mindcont/open-source/README.md

#  开源 OpenSource
本项目用来分享我所收集的优秀的开源代码。<br>
This folder will be used to share my collection of open source projects

## 开源代码目录
文件夹 | 说明 |
-----|--------|
Linux | Linus Torvalds 先生开源的早期 Linux 系统源码（含赵炯先生源码注释）
Apple II DOS | 苹果公司开源的早期 Apple II DOS系统源码
Microsoft DOS | 微软公司开源的早期 DOS 系统源码
Facebook | Facebook 开源硬件Surround360
Kinect | 适用于微软公司Kinect 硬件的开源驱动和工具
RaspberryPi | 整理的一些有趣树莓派开源项目

## 开源代码说明
用来整理收集开源项目，旨在帮助像我一样希望学习计算机精华与灵魂的东西，阅读这些伟大作品的早期源码
无疑是一份极好的材料，仅希望对那些苦苦搜索早期资料的朋友有一点帮助。
遵循署名-相同方式共享 3.0 协议，版权归原作者和出版公司所有.

* ### Linux
  ```
  目录下包括：linux-0.11中文注释(赵炯) | OldLinux | 书籍
  其中
  linux-0.11中文注释(赵炯) 由赵炯先生注释
  OldLinux 同样来自赵炯先生著作《Linux 内核完全注释》所提供的学习网站中的内容

  你可以访问下面的链接，了解更多。
      http://www.oldlinux.org/index_cn.html
      ftp:http://www.oldlinux.org/Linux.old/

  书籍 目录下分享我收集到的基本比较好的Linux 系统学习资料
  ```

* ### Apple II DOS
  ```
  目录下包括：Apple II DOS | Books |Pictures
  其中 Apple II DOS 下 斯科特LaBombard 重建

  斯科特LaBombard，专用的老式电脑收藏家/恢复在纽约，已经做了了不起的工作，研究和重建的Apple II DOS源代码。
  在归档中的“shepdos”目录代表了我们从保罗·劳顿得到了扫描的上市工作，
  以及“appledos31”目录包 含重建的源代码相匹配的生产由苹果公司发布了DOS 3.1二进制文件。谢谢，斯科特！

  More information,you can view http://www.computerhistory.org/atchm/apple-ii-dos-source-code/
  ```

* ### Microsoft DOS
  ```
  目录下包括：Projects| Word 1.1a CHM Distribution | Pictures
  其中 Microsoft DOS 下包括早期 DOS 源码和编译好的文件
  
  Word 1.1a CHM Distribution 下这包含源代码，因为它存在于1991年1月10日。
  这是源代码用于构建Windows 1.1a字，代号为“作品”。
  图片下 包含早期的 DOS 图片。
  ```

* ### Facebook
  ```java
  Surround360 is Facebook's open source hardware and software for capturing stereoscopic 3D 360 video for VR.
  The repo contains hardware designs, as well as software for camera control and rendering.
  ```

* ### RaspberryPi
分享我所收集的有趣树莓派项目，欢迎大家fork和push ( /) V (\ ) 嘻嘻~

文件夹 | 说明 | 作者 | 开源地址 |
----|----|----|-----|
Big Dog | 基于3D打印的开源大狗 | HuskyRobo| http://www.instructables.com/id/Fenrir-an-Open-Source-Dog-Robot/
ngrok | 穿透内网 | inconshreveable | https://github.com/inconshreveable/ngrok

## 致谢
在此，感谢所有致力于开放源代码并为之努力的朋友们！
