mindcont/open-source/Kinect/Kinect_v2/README.md

## Kinect v2
适用于微软公司Kinect v2硬件的开源驱动和工具  


文件 | 说明 |作者 | 开源地址 |
----|----|----|----|
libfreenect2 |Open source drivers for the Kinect v2| OpenKinect | https://github.com/OpenKinect/libfreenect2 |  
Skeltrack | A Free Software skeleton tracking library | joaquimrocha | https://github.com/avin2/SensorKinect |
