mindcont/open-source/Facebook/Surround360/surround360_camera_ctl/source/www/camera_capture/README.txt

== Things to modify/consider when putting this code on a new computer/camera rig ==
- capture_image.php: $num_cameras, $fps, master camera serial number
