mindcont/open-source/RaspberryPI/README.md

分享我所收集的有趣树莓派项目，相关项目的开源文件也可以在此路径相应文件夹下进行下载。欢迎大家fork和push ( /) V (\ ) 嘻嘻~

flying_pi

## 目录
文件夹 | 说明 | 作者 | 开源地址 |
----|----|----|-----|
Big Dog | 基于3D打印的开源大狗 | HuskyRobo| http://www.instructables.com/id/Fenrir-an-Open-Source-Dog-Robot/
ngrok | 穿透内网 | inconshreveable | https://github.com/inconshreveable/ngrok

## 致谢
在此，感谢所有致力于开放源代码并为之努力的朋友们！

#### 1、Big Dog  
一个利用3D打印机和树莓派制作的开源大狗机器人  
博客地址：http://www.instructables.com/id/Fenrir-an-Open-Source-Dog-Robot/  
源码地址：https://github.com/HackHusky/Fenrir  
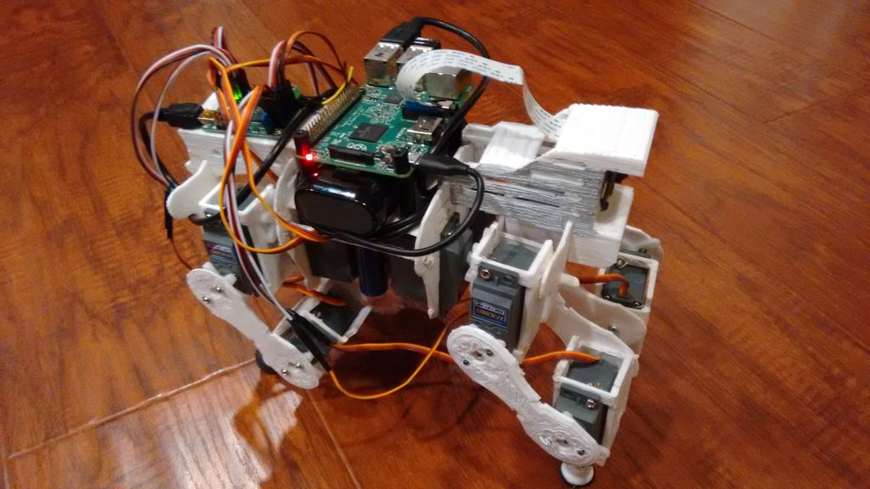
[picture p1: RaspberryPI/dog robot/dog robot.jpg]
dog robot
效果图： 

#### 2、ngrok  
穿透内网，可以远程控制家中路由下的树莓派喔～  
官网：https://ngrok.com/  
源码地址：https://github.com/inconshreveable/ngrok  
ngrok
