mindcont/open-source/Apple II DOS/Readme.txt

/************************************************
*
*	斯科特LaBombard，
*
*专用的老式电脑收藏家/恢复在纽约，已经做了了不起的工作，
*
*研究和重建的Apple II DOS源代码。他给了我们允许发布在这里他的工作结果：LaBombard_8Dec13.zip。（即本文件夹中的内容）
*
*在归档中的“shepdos”目录代表了我们从保罗·劳顿得到了扫描的上市工作，
*
*以及“appledos31”目录包 含重建的源代码相匹配的生产由苹果公司发布了DOS 3.1二进制文件。谢谢，斯科特！
*
*
*More information,you can view http://www.computerhistory.org/atchm/apple-ii-dos-source-code/
*
************************************************/
