mindcont/open-source/Kinect/Kinect_v1/README.md

## Kinect v1
适用于微软公司Kinect v1硬件的开源驱动和工具  


文件 | 说明 |作者 | 开源地址 |
----|----|----|----|
KinectCommonBridge-1.0.zip | Kinect Common Bridge | Microsoft Open Technologies, Inc | https://github.com/MSOpenTech/KinectCommonBridge |  
libfreenect-0.5.3.zip | Drivers and libraries | OpenKinect | https://github.com/OpenKinect/libfreenect |  
SensorKinect-0.93-5.1.2.1.zip | PrimeSensor Modules for OpenNI | avin2 | https://github.com/avin2/SensorKinect |  
OpenNI-Stable-1.5.7.10.zip | Open Natural Interaction | OpenNI | https://github.com/OpenNI/OpenNI |
