mindcont/open-source/Apple II DOS/pictures/01384303545.jpg_w600.jpg

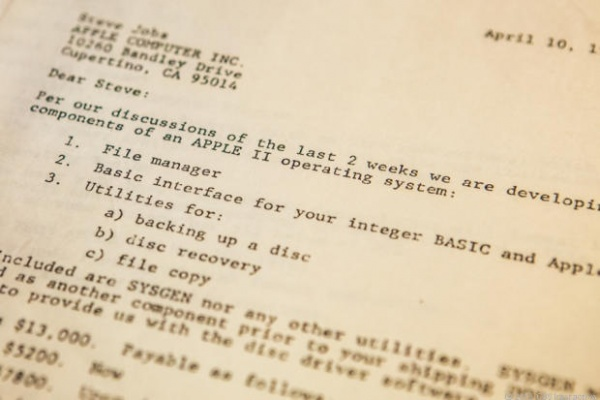
Apple II DOS/pictures/01384303545.jpg_w600.jpg
