mindcont/open-source/Apple II DOS/pictures/81384303567.jpg_w600.jpg

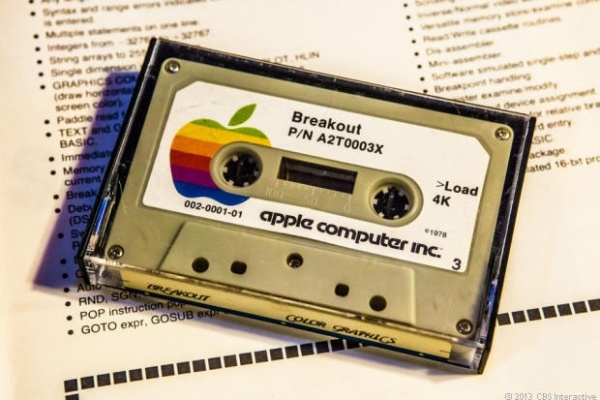
Apple II DOS/pictures/81384303567.jpg_w600.jpg
