mindcont/open-source/Apple II DOS/pictures/101384303572.jpg_w600.jpg

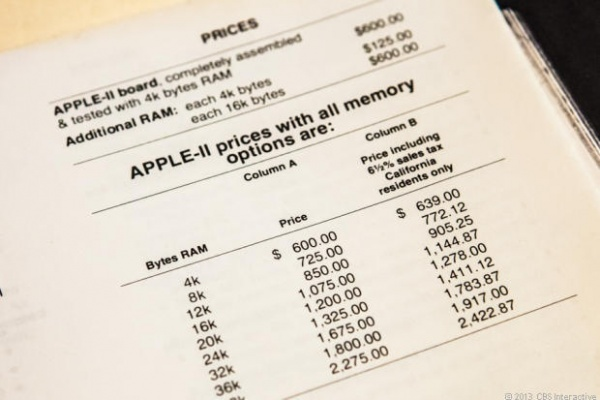
Apple II DOS/pictures/101384303572.jpg_w600.jpg
