mindcont/open-source/Apple II DOS/pictures/apple-II-02-542x347.jpg

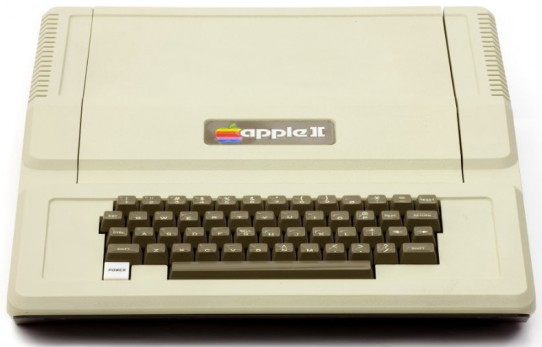
Apple II DOS/pictures/apple-II-02-542x347.jpg
