mindcont/open-source/Apple II DOS/pictures/apple-original-os-docs-2074_620x413.jpg

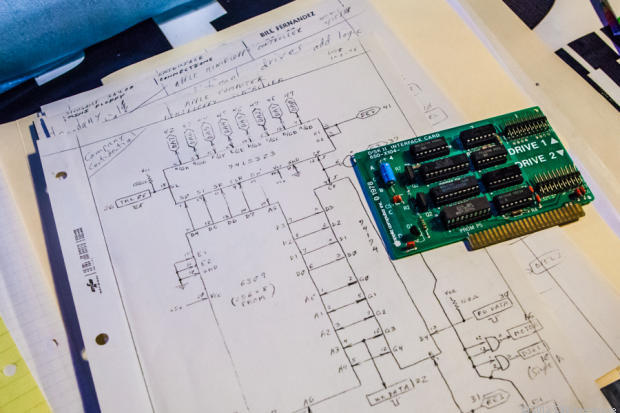
Apple II DOS/pictures/apple-original-os-docs-2074_620x413.jpg
