mindcont/open-source/Apple II DOS/pictures/pricelist_Oct1977.jpg

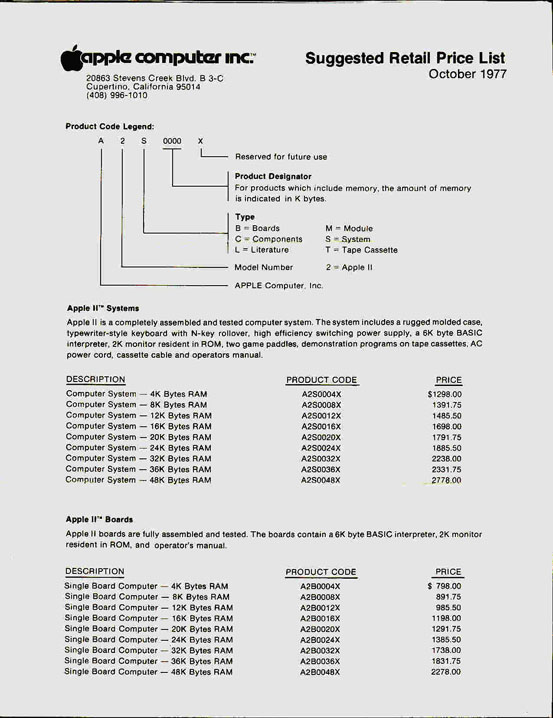
Apple II DOS/pictures/pricelist_Oct1977.jpg
