mindcont/open-source/Facebook/Surround360/surround360_design/3d_models/STEP_files/FB360_V1_33.STEP

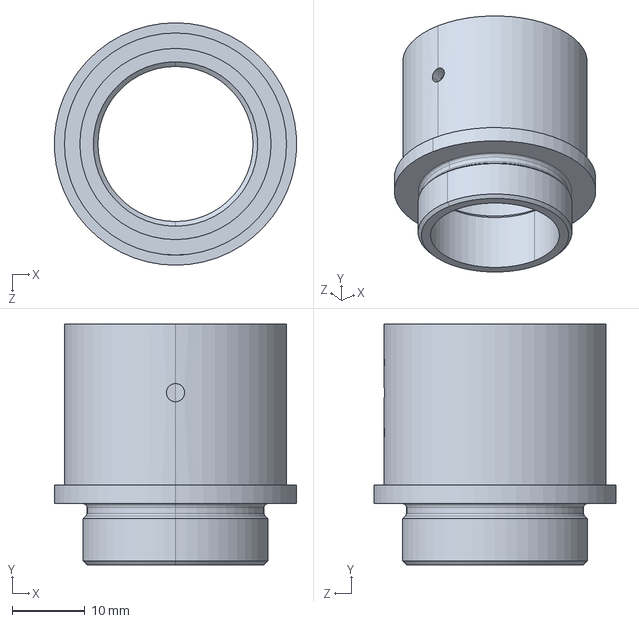
[picture p79: CAD file, 2016-07-31]
Facebook/Surround360/surround360_design/3d_models/STEP_files/FB360_V1_33.STEP
33.2 x 33.0 x 33.3 mm
