mindcont/open-source/(list of files, cad)

Other CAD files:
Microsoft DOS/Projects/v20object/SYSINIT.OBJ
Microsoft DOS/Word 1.1a CHM Distribution/Opus/sdm/dbg/sdmcomp.obj
Microsoft DOS/Word 1.1a CHM Distribution/Opus/sdm/hybrid/sdmnat2.obj
Microsoft DOS/Word 1.1a CHM Distribution/Opus/sdm/nondbg/sdmnat.obj
Microsoft DOS/Projects/v20object/FORMAT.OBJ
Microsoft DOS/Word 1.1a CHM Distribution/Opus/sdm/dbg/sdmnat2.obj
Microsoft DOS/Word 1.1a CHM Distribution/Opus/sdm/hybrid/sdmcomp.obj
Microsoft DOS/Word 1.1a CHM Distribution/Opus/sdm/nondbg/sdmdir2.obj
Microsoft DOS/Projects/v20object/FORMES.OBJ
Microsoft DOS/Word 1.1a CHM Distribution/Opus/sdm/dbg/wtimer.obj
Microsoft DOS/Word 1.1a CHM Distribution/Opus/sdm/hybrid/sdmnat.obj
Microsoft DOS/Word 1.1a CHM Distribution/Opus/sdm/nondbg/wtimer.obj
Microsoft DOS/Projects/v20object/SYSIMES.OBJ
Microsoft DOS/Word 1.1a CHM Distribution/Opus/sdm/dbg/sdmnat.obj
Microsoft DOS/Word 1.1a CHM Distribution/Opus/sdm/hybrid/sdmdir2.obj
Microsoft DOS/Word 1.1a CHM Distribution/Opus/sdm/nondbg/sdmcomp.obj
Microsoft DOS/Projects/v20object/PROFIL.OBJ
Microsoft DOS/Word 1.1a CHM Distribution/Opus/sdm/dbg/sdmdir2.obj
Microsoft DOS/Word 1.1a CHM Distribution/Opus/sdm/hybrid/wtimer.obj
Microsoft DOS/Word 1.1a CHM Distribution/Opus/sdm/nondbg/sdmnat2.obj
Facebook/Surround360/surround360_design/3d_models/STEP_files/160523_3.STEP
Facebook/Surround360/surround360_design/3d_models/STEP_files/FB360_V1_21.STEP
Facebook/Surround360/surround360_design/3d_models/STEP_files/FB360_V1_22.STEP
Facebook/Surround360/surround360_design/3d_models/STEP_files/FB360_V1_23.STEP
Facebook/Surround360/surround360_design/3d_models/STEP_files/FB360_V1_24.STEP
Facebook/Surround360/surround360_design/3d_models/STEP_files/FB360_V1_25.STEP
Facebook/Surround360/surround360_design/3d_models/STEP_files/FB360_V1_26.STEP
Facebook/Surround360/surround360_design/3d_models/STEP_files/FB360_V1_27.STEP
Facebook/Surround360/surround360_design/3d_models/STEP_files/FB360_V1_28.STEP
Facebook/Surround360/surround360_design/3d_models/STEP_files/FB360_V1_31.STEP
Facebook/Surround360/surround360_design/3d_models/STEP_files/FB360_V1_32.STEP
