mindcont/open-source/(commit log)

2015-10-23 Microsoft 早期的图片
2015-10-23 Microsoft DOS-v20source
    [CONFIG.txt]
2015-10-23 Microsoft DOS-v20object
    [FORMAT.OBJ, FORMES.OBJ, PROFIL.OBJ, SYSIMES.OBJ, SYSINIT.OBJ]
2015-10-23 Word 1.1a CHM Distribution
    Directory contents:
    Opus\...
    This contains the source code as it existed on January 10, 1991. This
    represents the sources code used to build Word for Windows 1.1a,
    codenamed "Opus". All of the tools used to build the sources should
    also in the Opus hierarchy. The product development team was able to
    build the product on MS-DOS as well as OS/2 (likely version 1.3x of
    OS/2). Most of the source code was built with a proprietary "csl"
    compiler that generated "pcode" that was run through an interpreter at
    runtime.
    OpusProg\...
    Some of the final product distribution is under this directory -- namely
    the techref documents as well as the readme documents.
    OpusEtAl\..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
    [sdmcomp.obj, sdmdir2.obj, sdmnat.obj, sdmnat2.obj, wtimer.obj]
2015-10-23 linux-0.11(中文注释)
    for more information ,
    please view http://www.oldlinux.org/index_cn.html
    ftp:http://www.oldlinux.org/Linux.old/
2015-10-23 有关linux学习相关书籍
2015-10-23 OldLinux
    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
    [Linux代码统计.xls]
2015-11-25 详细说明文档
2016-05-05 add RaspberryPi folder
2016-05-05 add project dog robot to RaspberryPi
2016-07-31 Add Facebook open hardware Surround360
    [160523_3.STEP, FB360_V1_21.STEP, FB360_V1_22.STEP, FB360_V1_23.STEP, FB360_V1_24.STEP, FB360_V1_25.STEP, FB360_V1_26.STEP, FB360_V1_27.STEP]
2016-07-31 Update Architecture for the repo
    [CONFIG.txt, FORMAT.OBJ, FORMES.OBJ, PROFIL.OBJ, SYSIMES.OBJ, SYSINIT.OBJ, sdmcomp.obj, sdmdir2.obj]
2016-08-07 Add open source drivers for the Kinect v2
